ccadic/ln-iwl250/iwl250pix/bottomopen.jpg

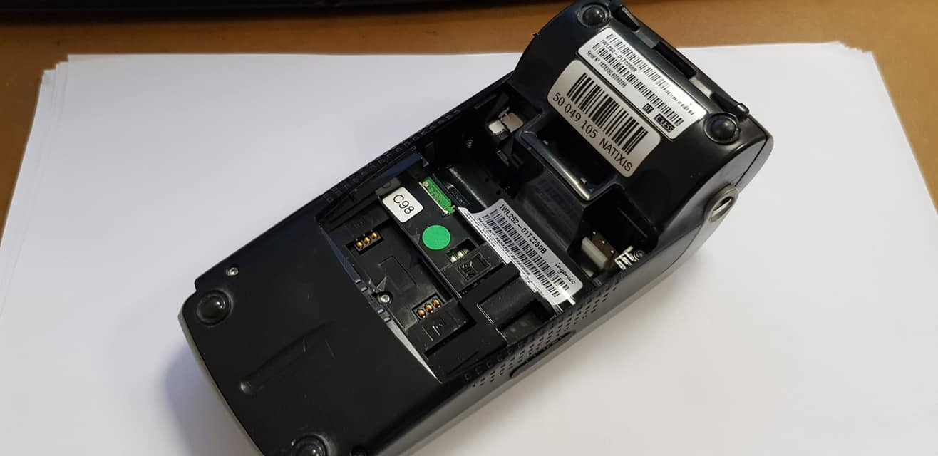
iwl250pix/bottomopen.jpg
