ccadic/ln-iwl250/iwl250pix/bottosisterpcb.jpg

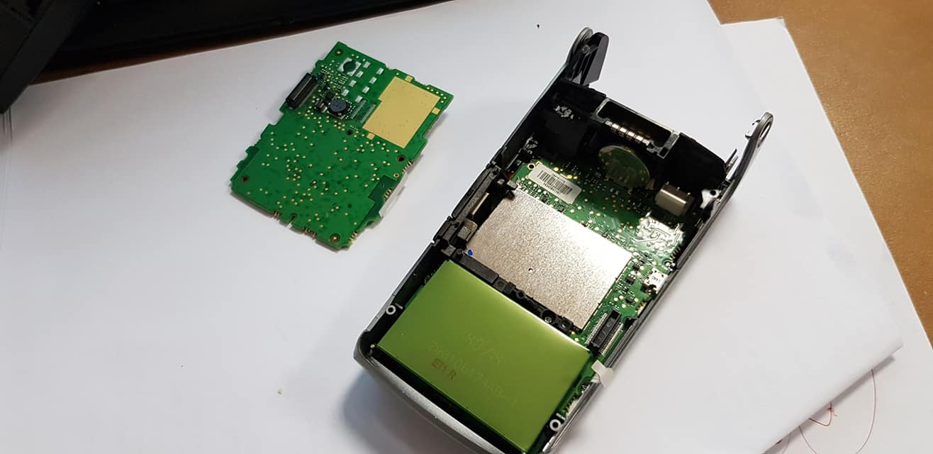
iwl250pix/bottosisterpcb.jpg
