ccadic/ln-iwl250/iwl250pix/display.jpg

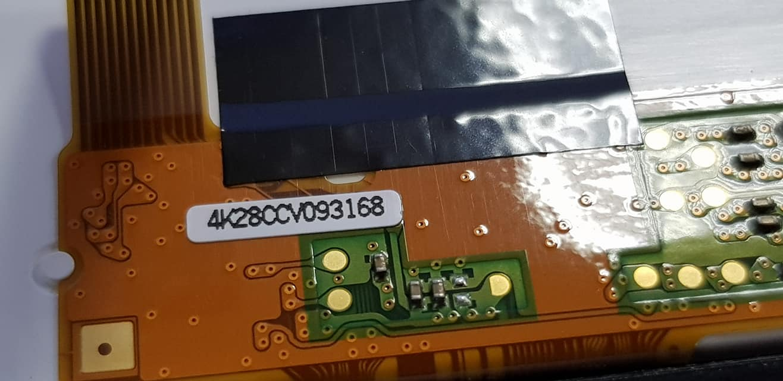
iwl250pix/display.jpg
