ccadic/ln-iwl250/iwl250pix/open1.jpg

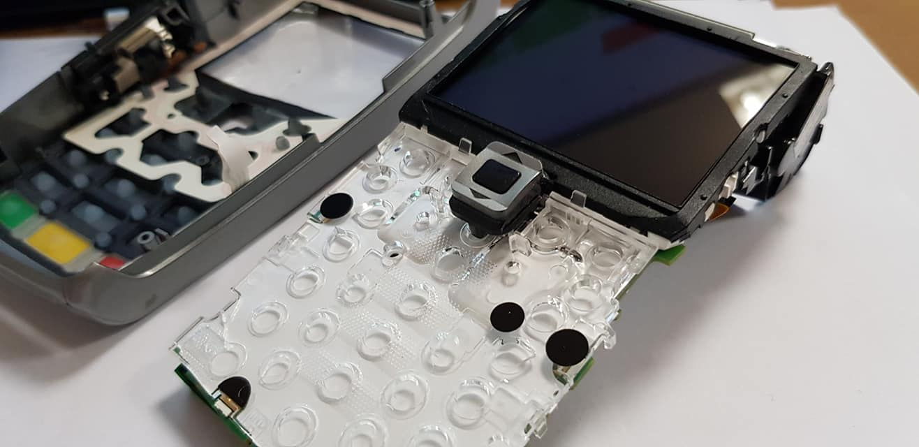
iwl250pix/open1.jpg
