ccadic/ln-iwl250/iwl250pix/open2.jpg

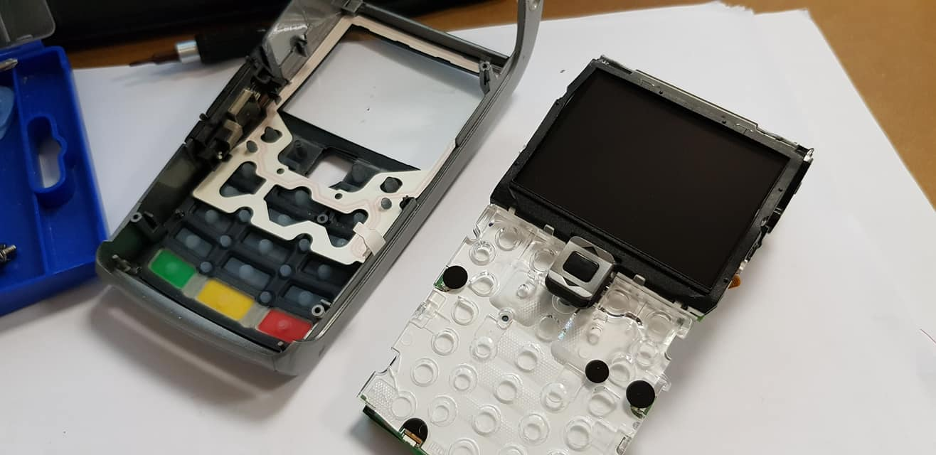
iwl250pix/open2.jpg
