ccadic/ln-iwl250/iwl250pix/openeddevice.jpg

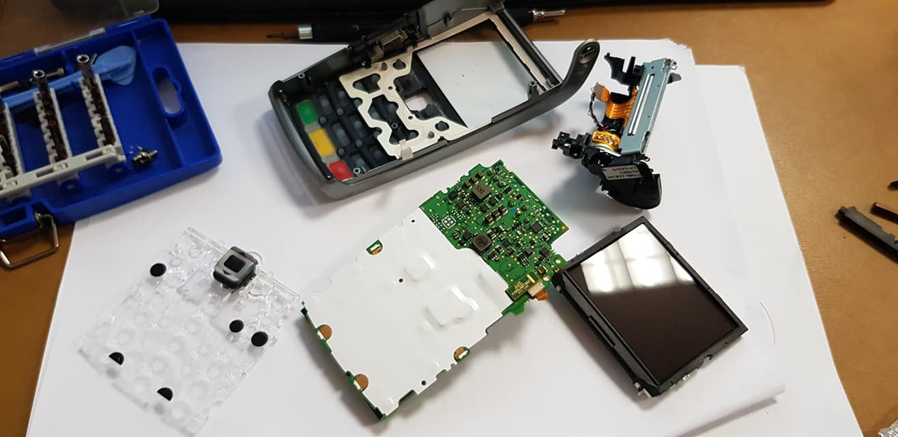
iwl250pix/openeddevice.jpg
