ccadic/ln-iwl250/iwl250pix/pcb-iwl250.JPG

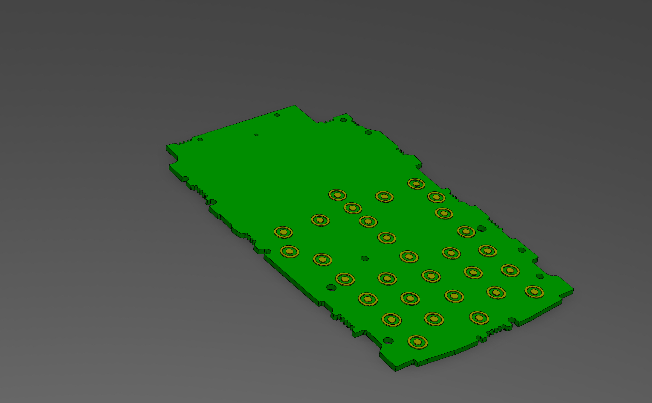
iwl250pix/pcb-iwl250.JPG
