ccadic/ln-iwl250/iwl250pix/thermalprinter.jpg

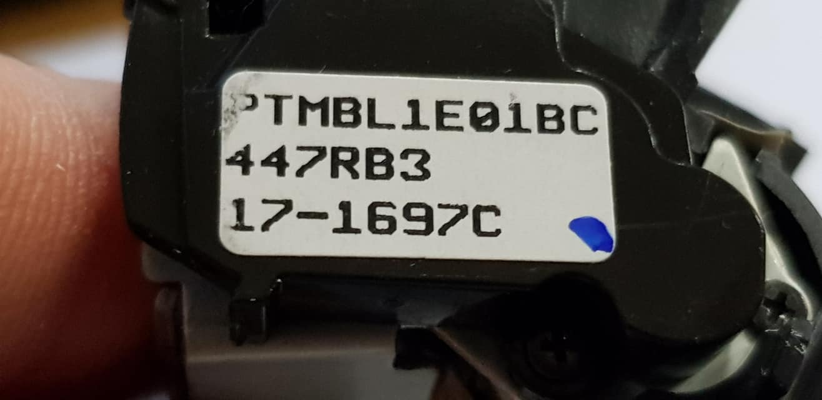
iwl250pix/thermalprinter.jpg
