ccadic/ln-iwl250/schem.jpg

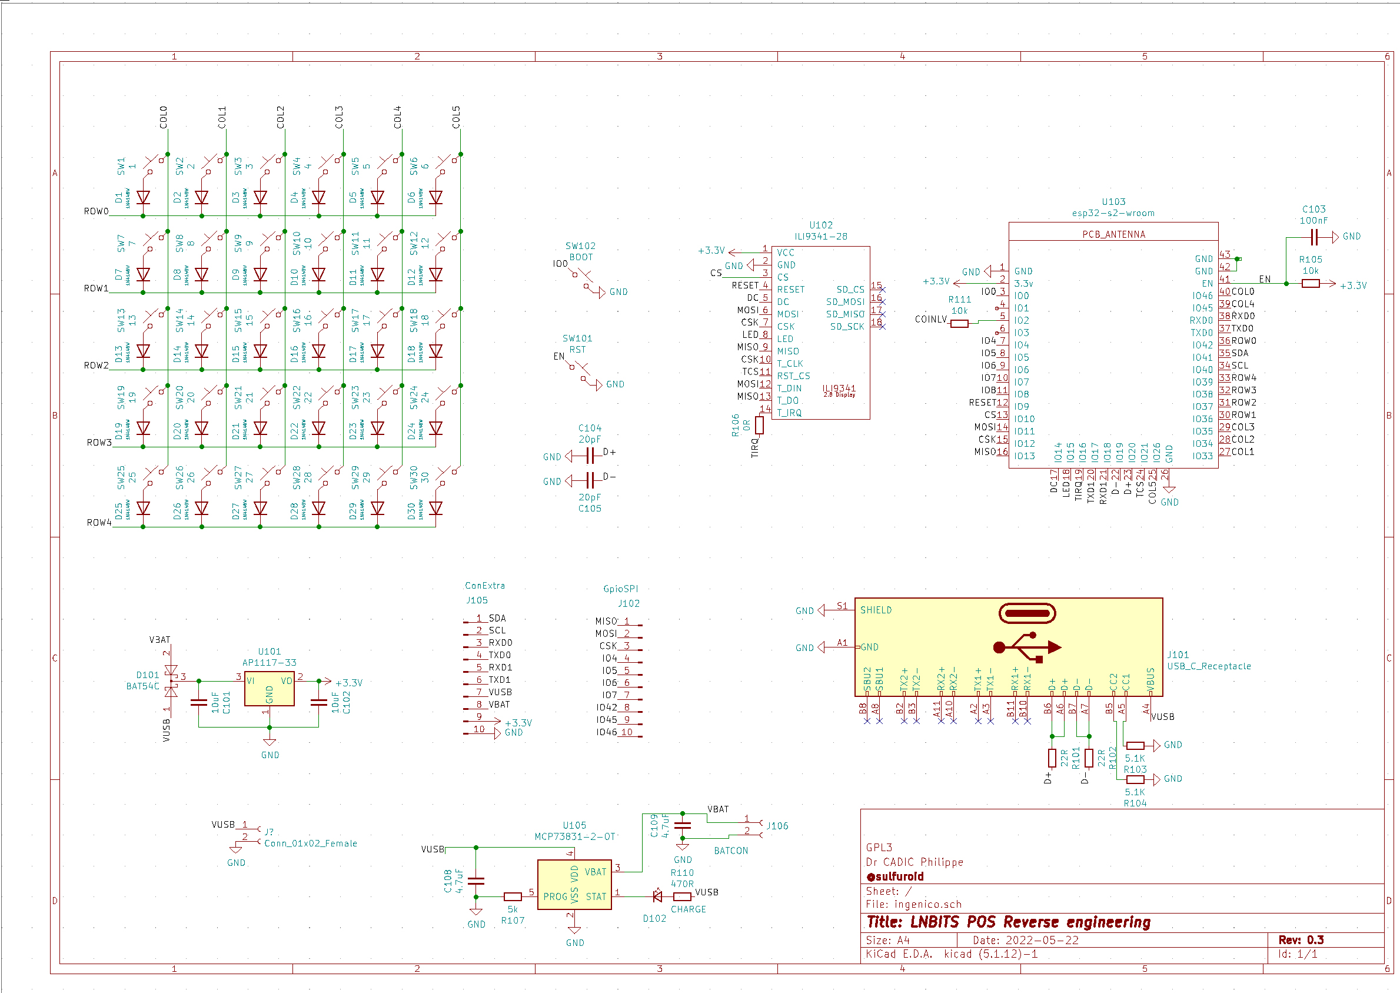
schem.jpg
