ccadic/ln-iwl250/pcb-iwl250.SLDPRT

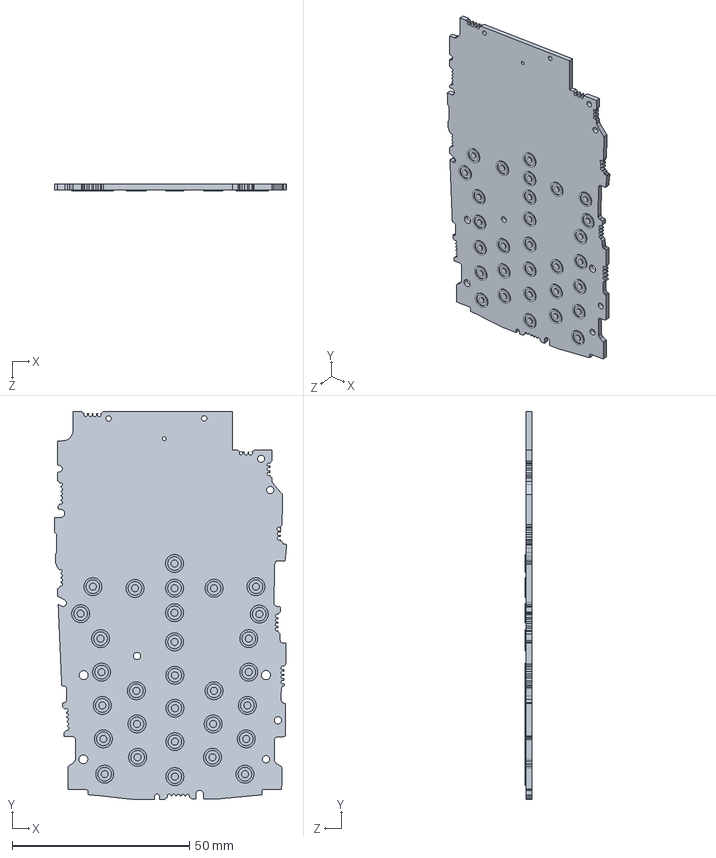
[picture p18: CAD file, 2022-05-17]
pcb-iwl250.SLDPRT
65.5 x 109.4 x 1.85 mm
