ccadic/ln-iwl250/(list of files, cad)

Other CAD files:
pcb-iwl250.DXF
