ccadic/ln-iwl250/ingenico/BTCPOS.sch

## KiCad design ingenico/BTCPOS.sch (2022-05-22)

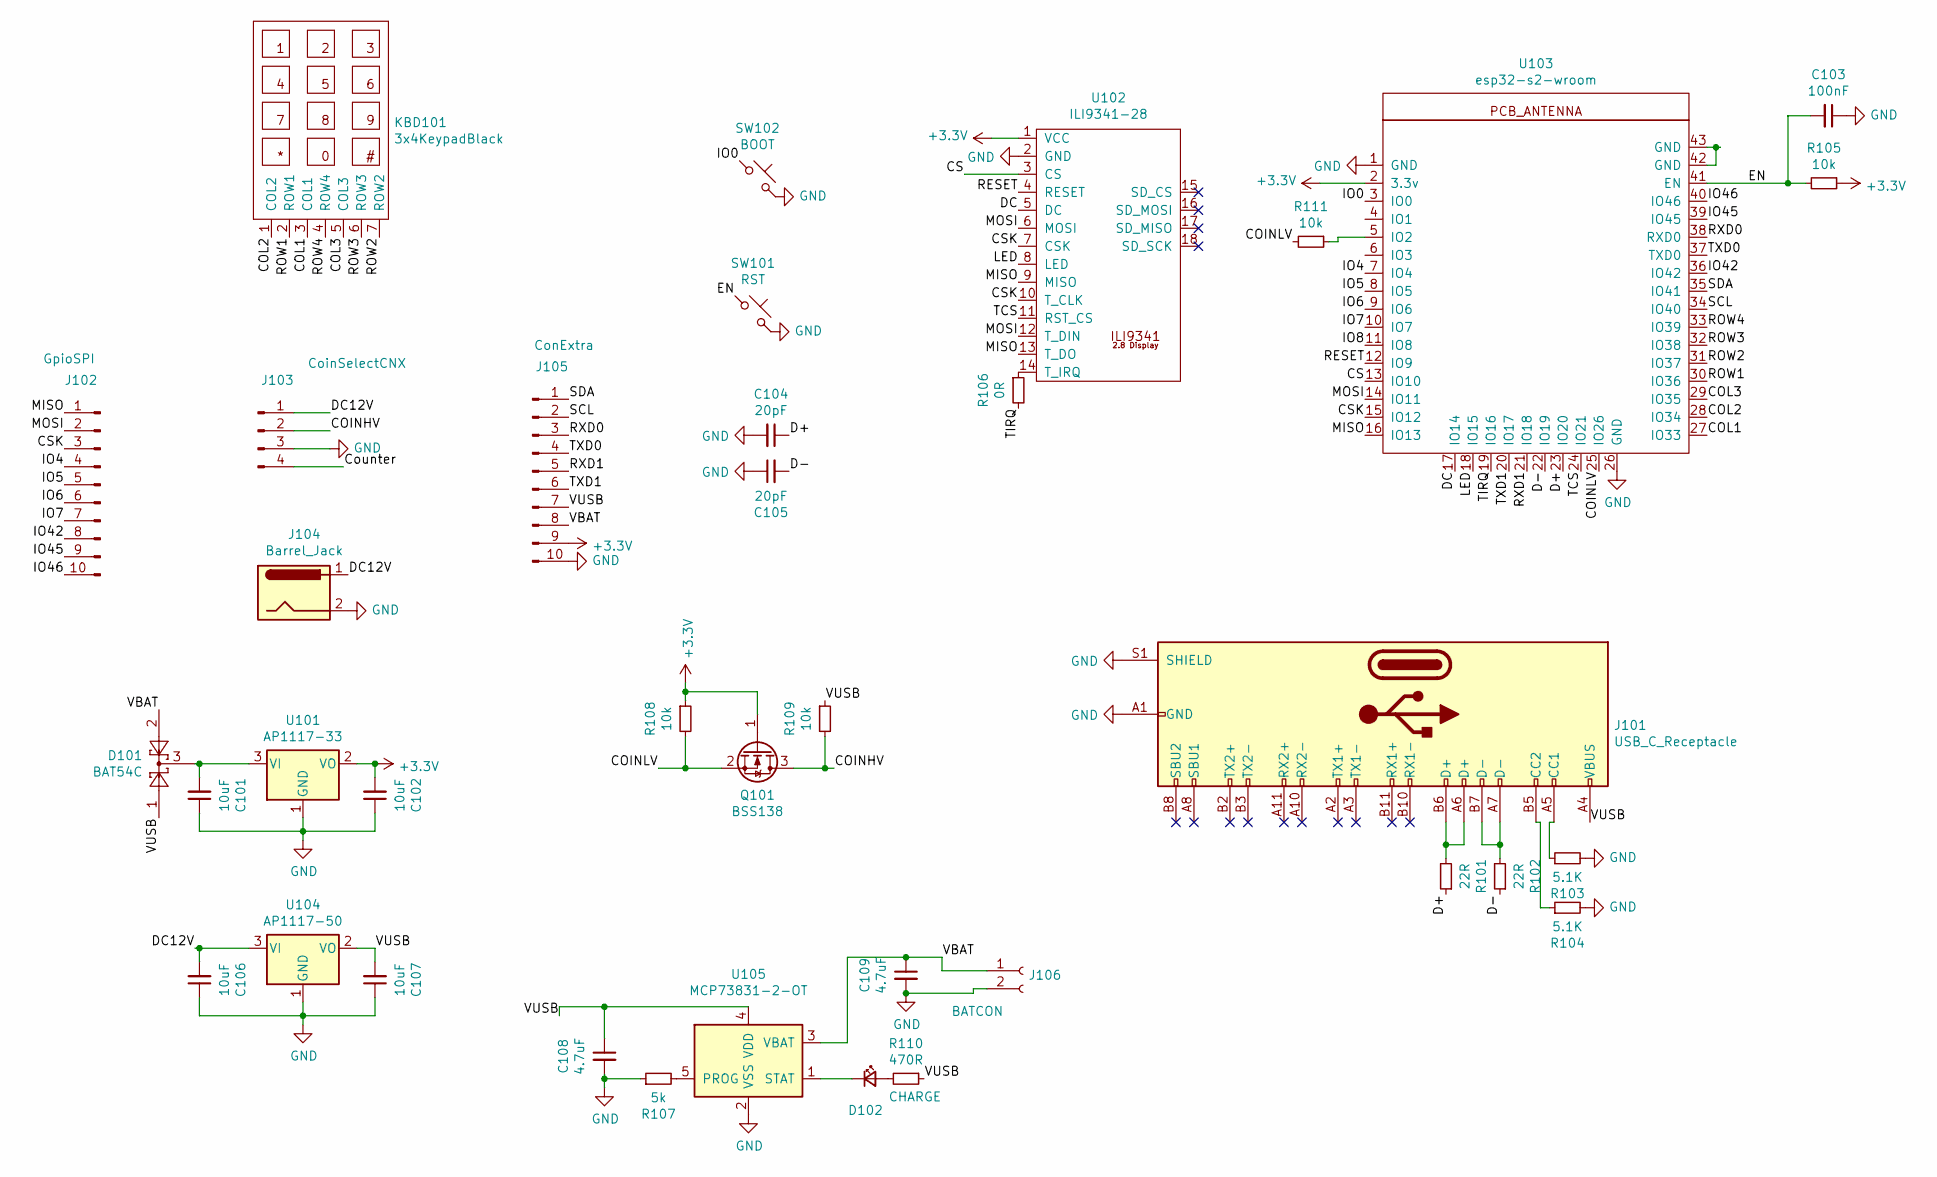
[picture p19: schematic BTCPOS.sch]

Parts:
C101, C102, C106, C107: 10uF; C_0805_2012Metric_Pad1.18x1.45mm_HandSolder
C103: 100nF; C_0805_2012Metric_Pad1.18x1.45mm_HandSolder
C104, C105: 20pF; C_0805_2012Metric_Pad1.18x1.45mm_HandSolder
C108, C109: 4.7uF; C_0805_2012Metric_Pad1.18x1.45mm_HandSolder
D101: BAT54C; SOT-23
D102: CHARGE; LED_0805_2012Metric_Pad1.15x1.40mm_HandSolder
J101: USB_C_Receptacle; GT-USB-7010
J102: GpioSPI; PinSocket_1x10_P2.54mm_Vertical
J103: CoinSelectCNX; TerminalBlock_bornier-4_P5.08mm
J104: Barrel_Jack; BARREL_JACK
J105: ConExtra; PinSocket_1x10_P2.54mm_Vertical
J106: BATCON; JST_PH_S2B-PH-SM4-TB_1x02-1MP_P2.00mm_Horizontal
KBD101: 3x4KeypadBlack; KeyPad_3x4
Q101: BSS138; SOT-23
R101, R102: 22R; R_0805_2012Metric_Pad1.20x1.40mm_HandSolder
R103, R104: 5.1K; R_0805_2012Metric_Pad1.20x1.40mm_HandSolder
R105, R108, R109, R111: 10k; R_0805_2012Metric_Pad1.20x1.40mm_HandSolder
R106: 0R; R_0805_2012Metric_Pad1.20x1.40mm_HandSolder
R107: 5k; R_0805_2012Metric_Pad1.20x1.40mm_HandSolder
R110: 470R; R_0805_2012Metric_Pad1.20x1.40mm_HandSolder
SW101: RST; SKRPABE010
SW102: BOOT; SKRPABE010
U101: AP1117-33; SOT-223-3_TabPin2
U102: ILI9341-28; ILI9341-2_8-noSD
U103: esp32-s2-wroom; esp32-s2-wrooom
U104: AP1117-50; SOT-223-3_TabPin2
U105: MCP73831-2-OT; SOT-23-5

Connections:
+3.3V: C102.2, J105.9, Q101.1 (G), R105.1, R108.1, U101.2 (VO), U102.1 (VCC), U103.2 (3.3v)
COINHV: J103.2, Q101.3 (D), R109.2
COINLV: Q101.2 (S), R108.2, R111.2, U103.25 (IO26)
COL1: KBD101.3 (COL1), U103.27 (IO33)
COL2: KBD101.1 (COL2), U103.28 (IO34)
COL3: KBD101.5 (COL3), U103.29 (IO35)
CS: U102.3 (CS), U103.13 (IO10)
CSK: J102.3, U102.7 (CSK), U102.10 (T_CLK), U103.15 (IO12)
Counter: J103.4
D+: C104.1, R101.1, U103.23 (IO20)
D-: C105.2, R102.1, U103.22 (IO19)
DC: U102.5 (DC), U103.17 (IO14)
DC12V: C106.2, J103.1, J104.1, U104.3 (VI)
EN: C103.2, R105.2, SW101.1, U103.41 (EN)
GND: C101.1, C102.1, C103.1, C104.2, C105.1, C106.1, C107.1, C108.2, C109.2, J101.A1 (GND), J101.A12 (GND), J101.B1 (GND), J101.B12 (GND), J101.S1 (SHIELD), J103.3, J104.2, J105.10, J106.2, R103.2, R104.2, R107.1, SW101.2, SW102.2, U101.1 (GND), U102.2 (GND), U103.1 (GND), U103.26 (GND), U104.1 (GND), U105.2 (VSS)
IO0: SW102.1, U103.3 (IO0)
IO4: J102.4, U103.7 (IO4)
IO5: J102.5, U103.8 (IO5)
IO6: J102.6, U103.9 (IO6)
IO7: J102.7, U103.10 (IO7)
IO8: U103.11 (IO8)
IO42: J102.8, U103.36 (IO42)
IO45: J102.9, U103.39 (IO45)
IO46: J102.10, U103.40 (IO46)
LED: U102.8 (LED), U103.18 (IO15)
MISO: J102.1, U102.9 (MISO), U102.13 (T_DO), U103.16 (IO13)
MOSI: J102.2, U102.6 (MOSI), U102.12 (T_DIN), U103.14 (IO11)
unnamed: C101.2, D101.3, U101.3 (VI)
unnamed: D102.1 (K), U105.1 (STAT)
unnamed: D102.2 (A), R110.2
unnamed: J101.A5 (CC1), R103.1
unnamed: J101.A6 (D+), J101.B6 (D+), R101.2
unnamed: J101.A7 (D-), J101.B7 (D-), R102.2
unnamed: J101.B5 (CC2), R104.1
unnamed: R106.1, U102.14 (T_IRQ)
unnamed: R107.2, U105.5 (PROG)
unnamed: R111.1, U103.5 (IO2)
unnamed: U103.42 (GND), U103.43 (GND)
RESET: U102.4 (RESET), U103.12 (IO9)
ROW1: KBD101.2 (ROW1), U103.30 (IO36)
ROW2: KBD101.7 (ROW2), U103.31 (IO37)
ROW3: KBD101.6 (ROW3), U103.32 (IO38)
ROW4: KBD101.4 (ROW4), U103.33 (IO39)
RXD0: J105.3, U103.38 (RXD0)
RXD1: J105.5, U103.21 (IO18)
SCL: J105.2, U103.34 (IO40)
SDA: J105.1, U103.35 (IO41)
TCS: U102.11 (RST_CS), U103.24 (IO21)
TIRQ: R106.2, U103.19 (IO16)
TXD0: J105.4, U103.37 (TXD0)
TXD1: J105.6, U103.20 (IO17)
VBAT: C109.1, D101.2, J105.8, J106.1, U105.3 (VBAT)
VUSB: C107.2, C108.1, D101.1, J101.A4 (VBUS), J101.A9 (VBUS), J101.B4 (VBUS), J101.B9 (VBUS), J105.7, R109.1, R110.1, U104.2 (VO), U105.4 (VDD)
